GankhulugD/Khishigbayar-s-motion-detector/docs/diagrams/01_tsahilgaan_schem.png

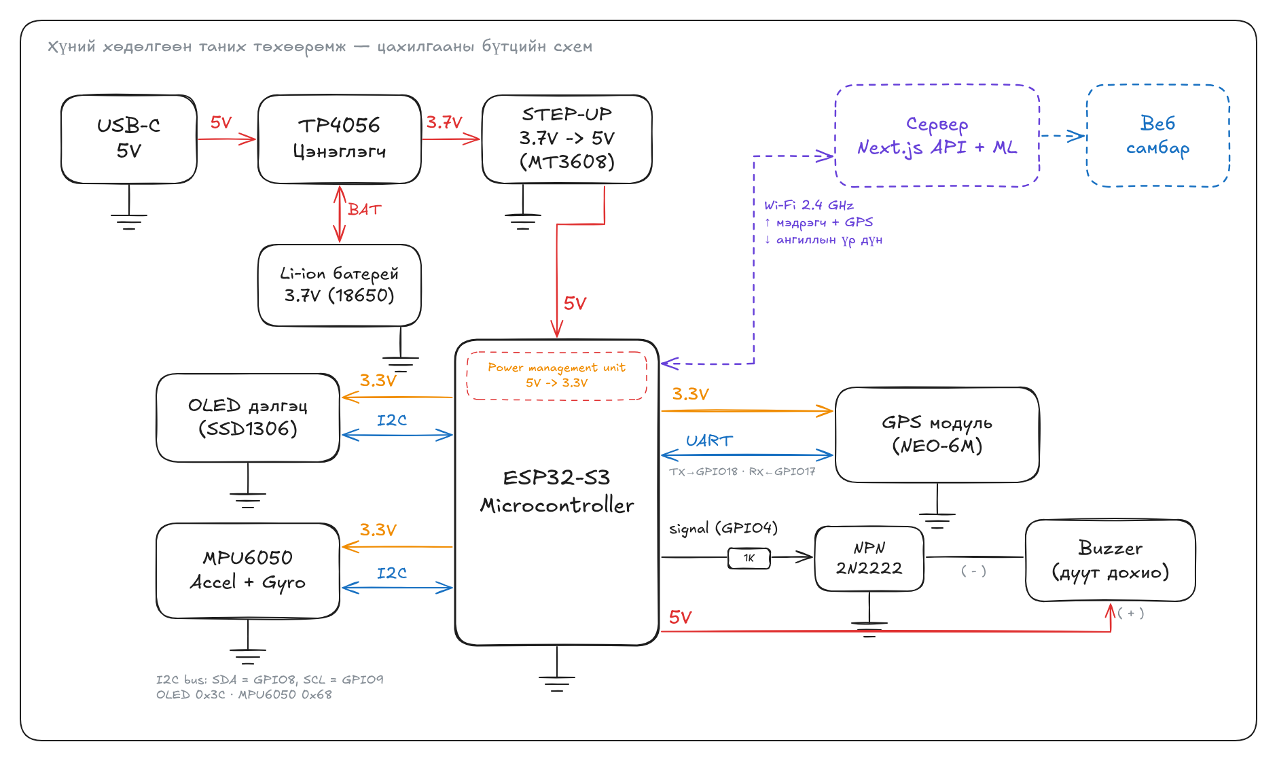
docs/diagrams/01_tsahilgaan_schem.png
