GankhulugD/Khishigbayar-s-motion-detector/docs/diagrams/02_sistemiin_butets.png

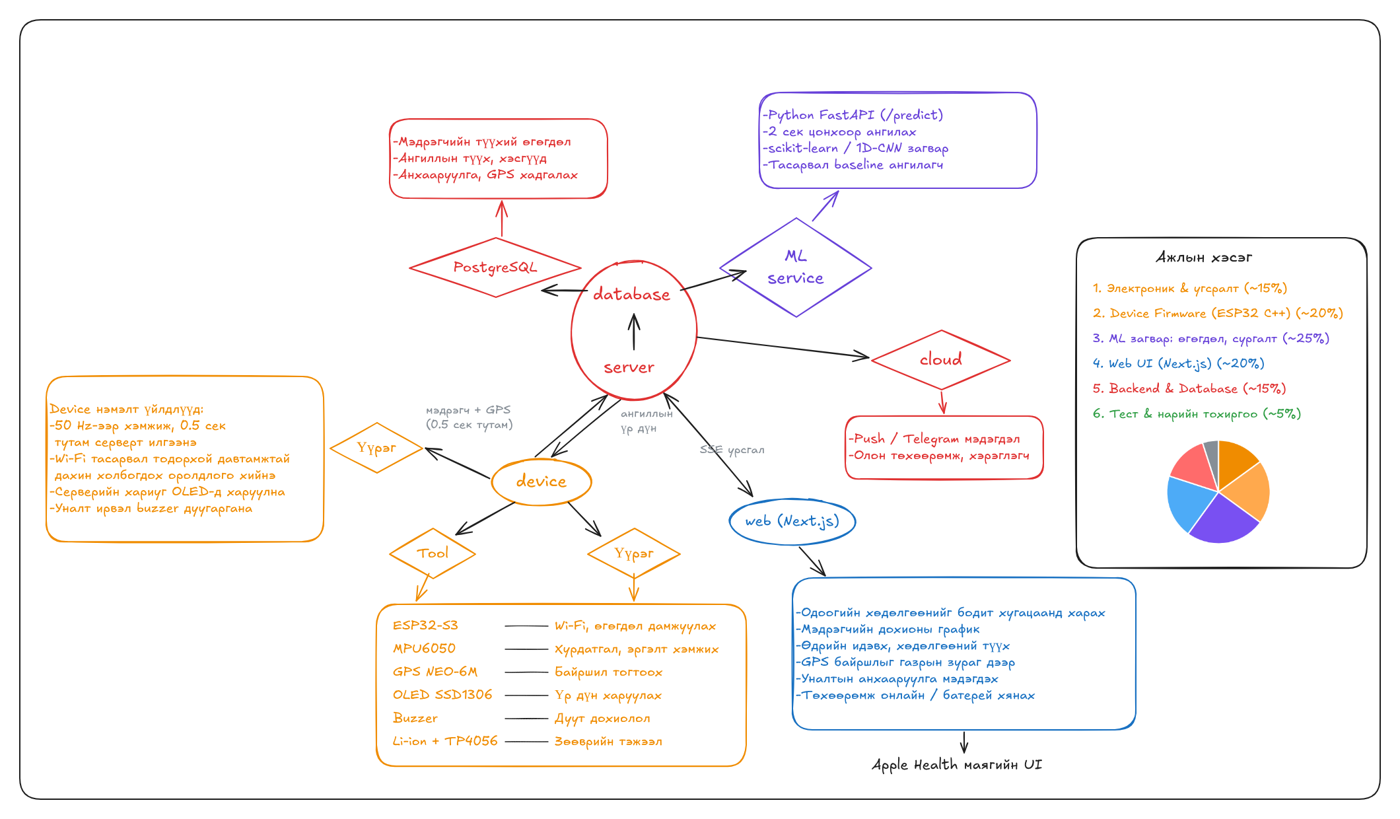
docs/diagrams/02_sistemiin_butets.png
