GankhulugD/Khishigbayar-s-motion-detector/hardware/pcb/pcb_bottom.png

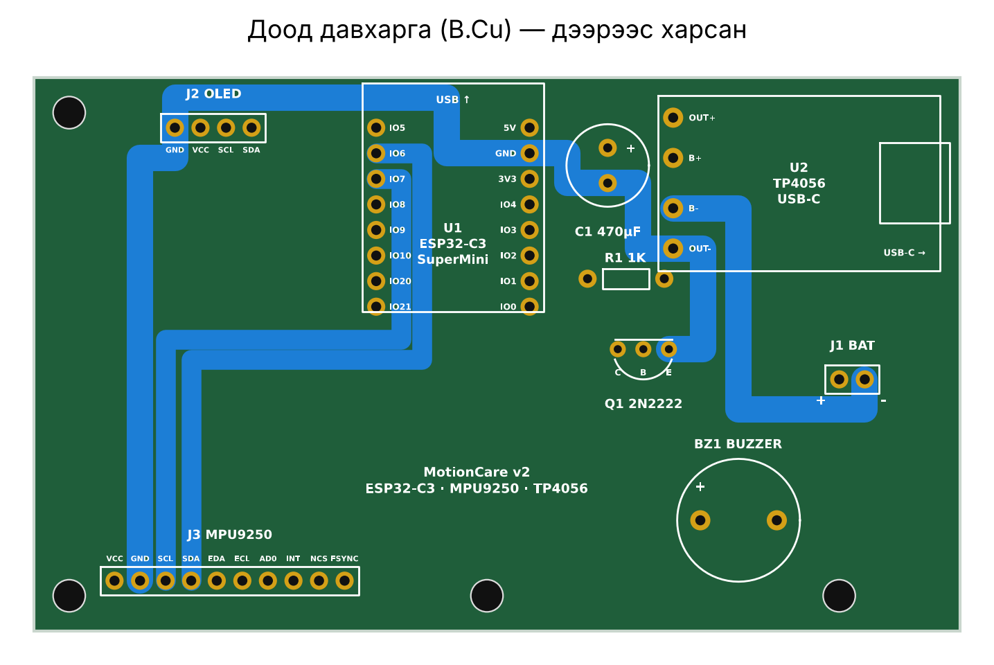
hardware/pcb/pcb_bottom.png
