GankhulugD/Khishigbayar-s-motion-detector/hardware/pcb/pcb_combined.png

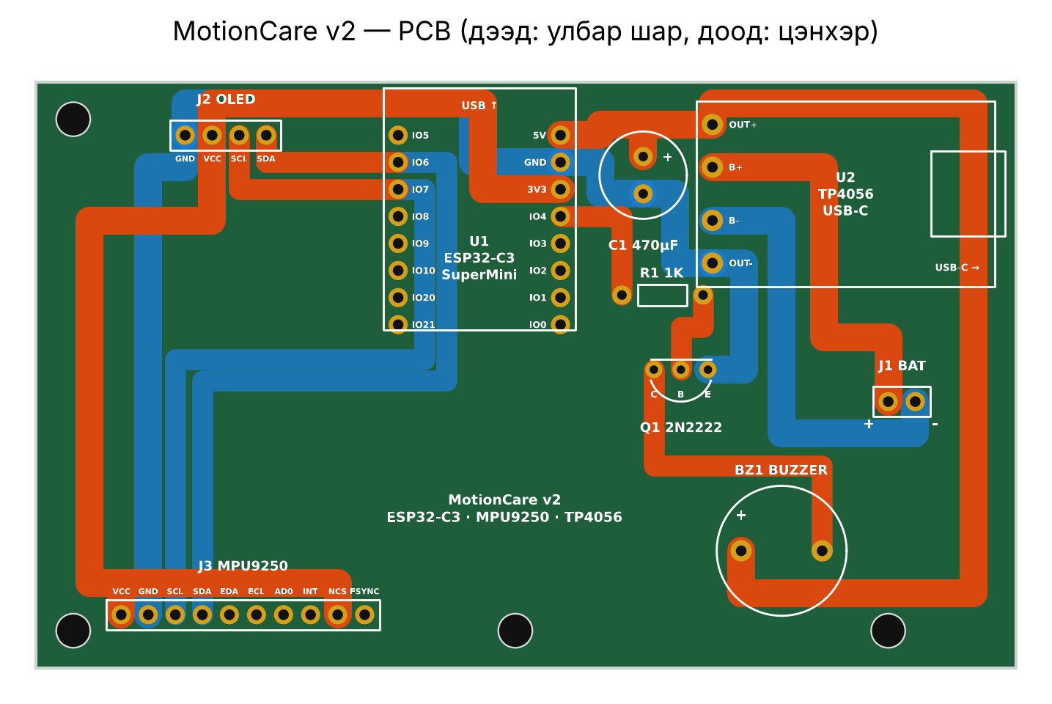
hardware/pcb/pcb_combined.png
