GankhulugD/Khishigbayar-s-motion-detector/hardware/pcb/pcb_top.png

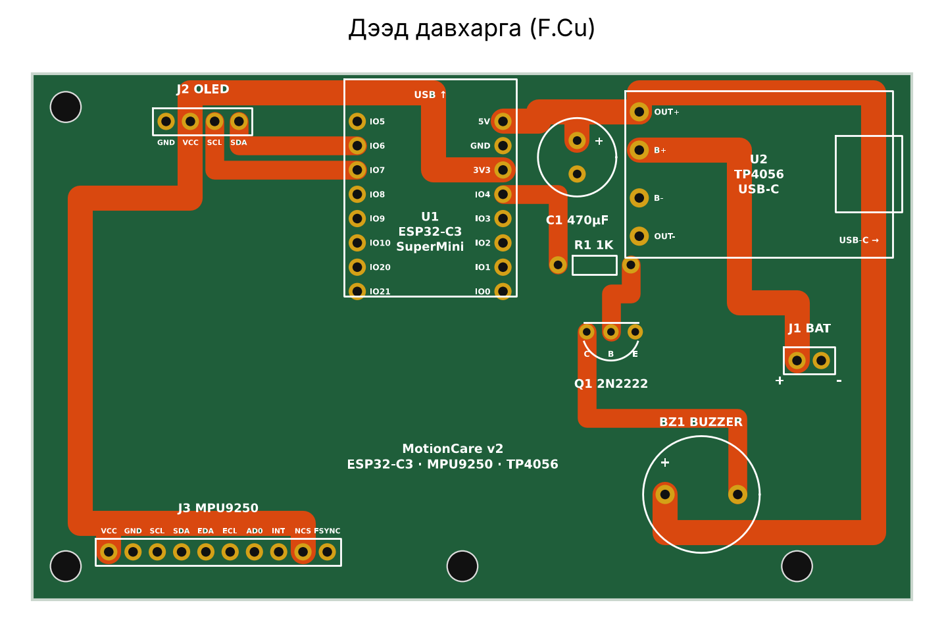
hardware/pcb/pcb_top.png
