GankhulugD/Khishigbayar-s-motion-detector/hardware/pcb_v4/pcb_v4_overview.png

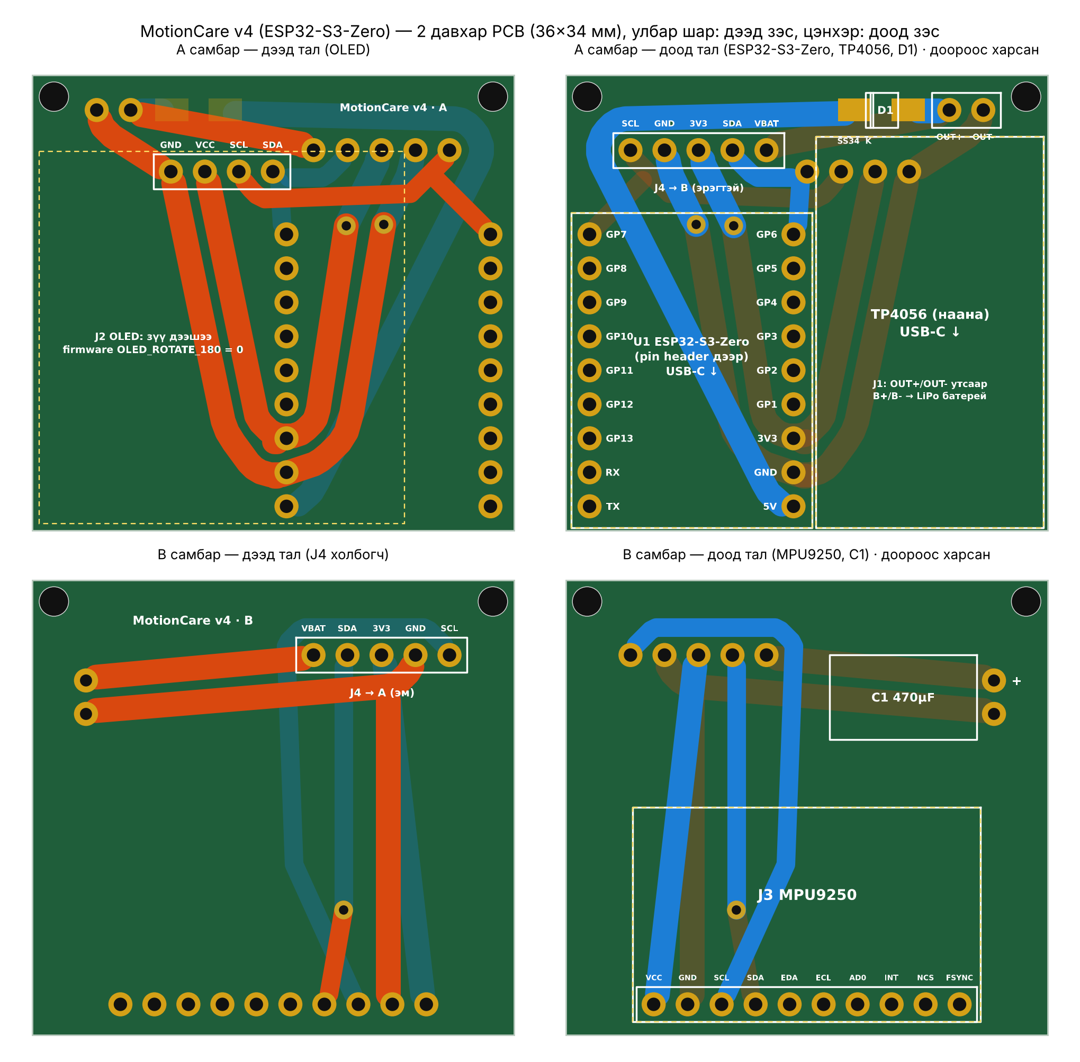
hardware/pcb_v4/pcb_v4_overview.png
