GankhulugD/Khishigbayar-s-motion-detector/hardware/pcb_v4/stack_side_view.png

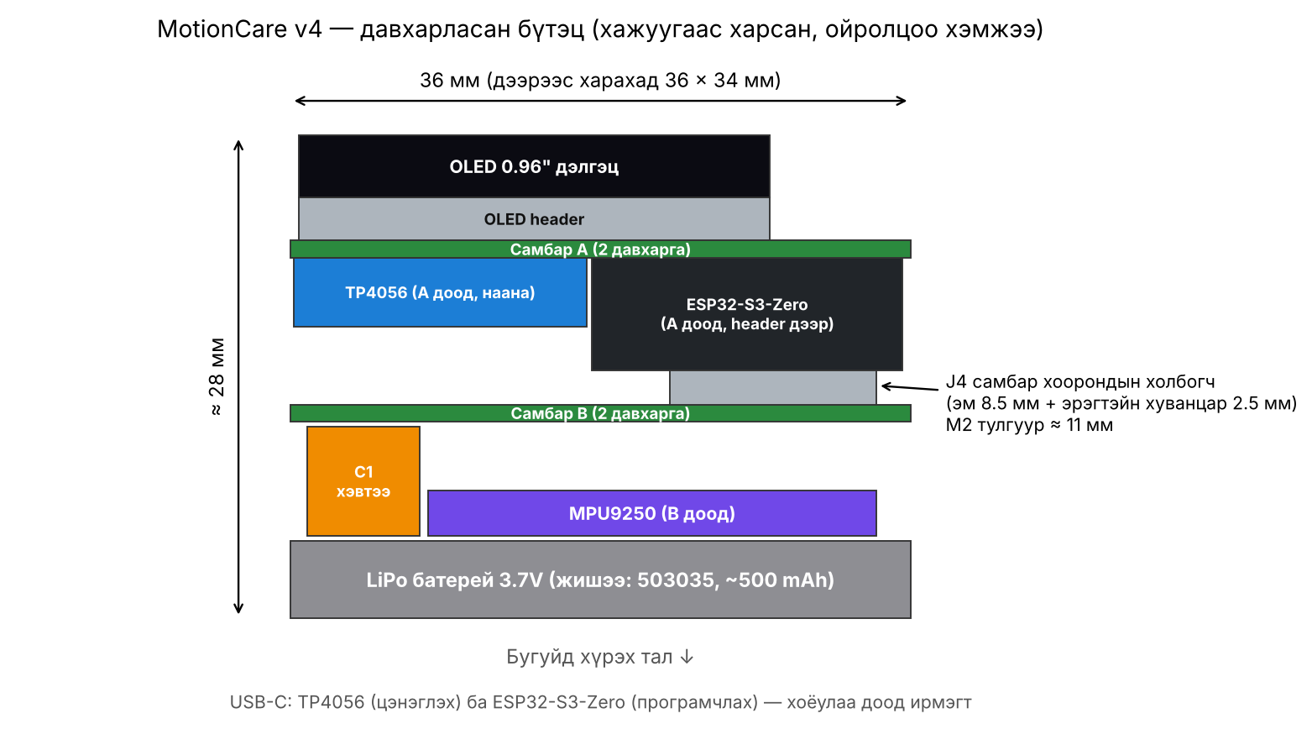
hardware/pcb_v4/stack_side_view.png
