GankhulugD/Khishigbayar-s-motion-detector/hardware/pcb/source/layout.py

"""MotionCare v2 — ESP32-C3 SuperMini carrier board (2 давхарга, THT).
Координат: мм, зүүн дээд булан (0,0), y доошоо.  Дамжуулагч: дохио 60 mil, тэжээл 80 mil."""

MIL = 0.0254
W_SIG = 60 * MIL      # 1.524 мм
W_PWR = 80 * MIL      # 2.032 мм
BOARD = (92.0, 55.0)
CLEARANCE = 0.30

# ---------------------------------------------------------------- эд ангиуд
# pad: (name, x, y, pad_diameter, drill, net)
parts = {}

def add(ref, pads, silk=None, label=None, value=""):
    parts[ref] = {"pads": pads, "silk": silk or [], "label": label, "value": value}

# U1 ESP32-C3 SuperMini, USB дээш, нүүрээр харсан байдлаар:
#   зүүн багана: GPIO5,6,7,8,9,10,20,21    баруун багана: 5V,GND,3V3,GPIO4,3,2,1,0
UX_L, UX_R, UY0, P = 34.0, 49.24, 5.0, 2.54
left = ["IO5", "IO6", "IO7", "IO8", "IO9", "IO10", "IO20", "IO21"]
right = ["5V", "GND", "3V3", "IO4", "IO3", "IO2", "IO1", "IO0"]
lnet = {"IO6": "SDA", "IO7": "SCL"}
rnet = {"5V": "VBAT", "GND": "GND", "3V3": "3V3", "IO4": "BUZ_B"}
u1 = [(n, UX_L, UY0 + i * P, 1.8, 1.0, lnet.get(n)) for i, n in enumerate(left)] + \
     [(n, UX_R, UY0 + i * P, 1.8, 1.0, rnet.get(n)) for i, n in enumerate(right)]
add("U1", u1, silk=[("rect", 32.62, 0.6, 50.62, 23.3)], label=(41.62, 16.5), value="ESP32-C3\nSuperMini")

# J2 OLED SSD1306 (I2C, 4 pin): GND VCC SCL SDA
oled = [("GND", 14.0, 5, 1.8, 1.0, "GND"), ("VCC", 16.54, 5, 1.8, 1.0, "3V3"),
        ("SCL", 19.08, 5, 1.8, 1.0, "SCL"), ("SDA", 21.62, 5, 1.8, 1.0, "SDA")]
add("J2", oled, silk=[("rect", 12.6, 3.6, 23.0, 6.4)], label=(17.8, 1.6), value="OLED")

# J3 MPU9250 (GY-9250, 10 pin): VCC GND SCL SDA EDA ECL AD0 INT NCS FSYNC
mpu_names = ["VCC", "GND", "SCL", "SDA", "EDA", "ECL", "AD0", "INT", "NCS", "FSYNC"]
mpu_net = {"VCC": "3V3", "GND": "GND", "SCL": "SCL", "SDA": "SDA", "NCS": "3V3"}
mpu = [(n, 8.0 + i * P, 50.0, 1.8, 1.0, mpu_net.get(n)) for i, n in enumerate(mpu_names)]
add("J3", mpu, silk=[("rect", 6.6, 48.6, 32.26, 51.4)], label=(19.4, 45.4), value="MPU9250")

# U2 TP4056 цэнэглэгч модуль (USB-C, хамгаалалттай), USB нь баруун ирмэг рүү
TPX = 63.5
add("U2", [("OUT+", TPX, 4.0, 2.0, 1.0, "VBAT"), ("B+", TPX, 8.0, 2.0, 1.0, "BATP"),
           ("B-", TPX, 13.0, 2.0, 1.0, "BATN"), ("OUT-", TPX, 17.0, 2.0, 1.0, "GND")],
    silk=[("rect", 62.0, 1.8, 90.0, 19.2), ("rect", 84.0, 6.5, 91.0, 14.5)], label=(76.0, 10.5), value="TP4056\nUSB-C")

# J1 батерейн холбогч (Li-ion 18650)
add("J1", [("+", 80.0, 30.0, 1.8, 1.0, "BATP"), ("-", 82.54, 30.0, 1.8, 1.0, "BATN")],
    silk=[("rect", 78.6, 28.6, 83.94, 31.4)], label=(81.3, 26.6), value="BAT")

# C1 470µF электролит (3.5 мм алхам)
add("C1", [("+", 57.0, 7.0, 1.8, 0.9, "VBAT"), ("-", 57.0, 10.5, 1.8, 0.9, "GND")],
    silk=[("circle", 57.0, 8.75, 4.1)], label=(57.0, 15.3), value="470µF")

# R1 1K (7.62 мм)
add("R1", [("1", 55.0, 20.0, 1.8, 0.9, "BUZ_B"), ("2", 62.62, 20.0, 1.8, 0.9, "BUZ_Q")],
    silk=[("rect", 56.5, 19.0, 61.12, 21.0)], label=(58.81, 17.9), value="1K")

# Q1 2N2222 TO-92 (C B E)
add("Q1", [("C", 58.0, 27.0, 1.6, 0.8, "BUZ_N"), ("B", 60.54, 27.0, 1.6, 0.8, "BUZ_Q"),
           ("E", 63.08, 27.0, 1.6, 0.8, "GND")],
    silk=[("arc", 60.54, 27.0, 3.0)], label=(60.54, 32.4), value="2N2222")

# BZ1 buzzer (12 мм, 7.6 мм алхам)
add("BZ1", [("+", 66.2, 44.0, 2.0, 1.0, "VBAT"), ("-", 73.8, 44.0, 2.0, 1.0, "BUZ_N")],
    silk=[("circle", 70.0, 44.0, 6.1)], label=(70.0, 36.4), value="BUZZER")

MOUNT = [(3.5, 3.5), (3.5, 51.5), (45.0, 51.5), (80.0, 51.5)]  # M3, NPTH 3.2 мм

# ---------------------------------------------------------------- дамжуулагч
# (net, layer, width, [(x,y), ...])   layer: "F" = дээд, "B" = доод
T, B = "F", "B"
traces = [
    # I2C → OLED (дээд)
    ("SDA", T, W_SIG, [(34.0, 7.54), (21.62, 7.54), (21.62, 5.0)]),
    ("SCL", T, W_SIG, [(34.0, 10.08), (19.08, 10.08), (19.08, 5.0)]),
    # I2C → MPU9250 (доод, модулийн доогуур)
    ("SDA", B, W_SIG, [(34.0, 7.54), (38.5, 7.54), (38.5, 28.0), (15.62, 28.0), (15.62, 50.0)]),
    ("SCL", B, W_SIG, [(34.0, 10.08), (36.5, 10.08), (36.5, 26.0), (13.08, 26.0), (13.08, 50.0)]),
    # 3V3 (дээд) — OLED, MPU9250 VCC, NCS (I2C горим)
    ("3V3", T, W_PWR, [(49.24, 10.08), (42.0, 10.08), (42.0, 2.0), (16.54, 2.0), (16.54, 5.0)]),
    ("3V3", T, W_PWR, [(16.54, 5.0), (16.54, 13.0), (5.0, 13.0), (5.0, 47.0), (8.0, 47.0), (8.0, 50.0)]),
    ("3V3", T, W_PWR, [(8.0, 47.0), (28.32, 47.0), (28.32, 50.0)]),
    # GND (доод)
    ("GND", B, W_PWR, [(49.24, 7.54), (41.0, 7.54), (41.0, 2.0), (14.0, 2.0), (14.0, 5.0)]),
    ("GND", B, W_PWR, [(14.0, 5.0), (14.0, 8.0), (10.54, 8.0), (10.54, 50.0)]),
    ("GND", B, W_PWR, [(TPX, 17.0), (60.0, 17.0), (60.0, 10.5), (57.0, 10.5)]),
    ("GND", B, W_PWR, [(57.0, 10.5), (53.0, 10.5), (53.0, 7.54), (49.24, 7.54)]),
    ("GND", B, W_PWR, [(TPX, 17.0), (66.5, 17.0), (66.5, 27.0), (63.08, 27.0)]),
    # VBAT = TP4056 OUT+ (дээд)
    ("VBAT", T, W_PWR, [(TPX, 4.0), (57.0, 4.0), (57.0, 7.0)]),
    ("VBAT", T, W_PWR, [(57.0, 4.0), (53.0, 4.0), (53.0, 5.0), (49.24, 5.0)]),
    ("VBAT", T, W_PWR, [(TPX, 4.0), (TPX, 2.0), (88.0, 2.0), (88.0, 48.0), (66.2, 48.0), (66.2, 44.0)]),
    # Батерей ↔ TP4056
    ("BATP", T, W_PWR, [(TPX, 8.0), (74.0, 8.0), (74.0, 24.0), (80.0, 24.0), (80.0, 30.0)]),
    ("BATN", B, W_PWR, [(TPX, 13.0), (70.0, 13.0), (70.0, 33.0), (82.54, 33.0), (82.54, 30.0)]),
    # Buzzer удирдлага
    ("BUZ_B", T, W_SIG, [(49.24, 12.62), (55.0, 12.62), (55.0, 20.0)]),
    ("BUZ_Q", T, W_SIG, [(62.62, 20.0), (62.62, 23.0), (60.54, 23.0), (60.54, 27.0)]),
    ("BUZ_N", T, W_SIG, [(73.8, 44.0), (73.8, 36.0), (58.0, 36.0), (58.0, 27.0)]),
]
