GankhulugD/Khishigbayar-s-motion-detector/(commit log)

2026-10-07 Add the MotionCare motion-detection dashboard.
    Ship the live board, demo simulator, ESP32 client, and ML service so the system can run before a physical device is connected.
2026-10-11 test successfull
    [MotionCare_A-NPTH.DRL, MotionCare_A-PTH.DRL, MotionCare_A.GBL, MotionCare_A.GBO, MotionCare_A.GBS, MotionCare_A.GKO, MotionCare_A.GTL, MotionCare_A.GTO]
